mnruecke/RDS_WOTAN/Wotanboard_6CH.png

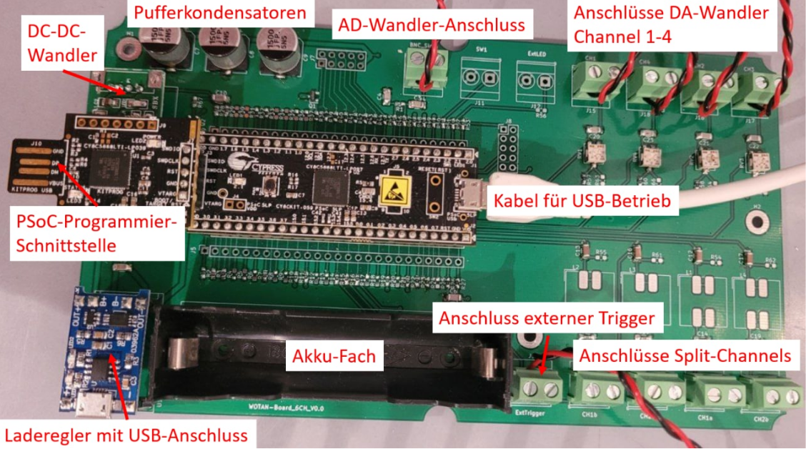
Wotanboard_6CH.png
