mnruecke/RDS_WOTAN/spectrometer_setup.png

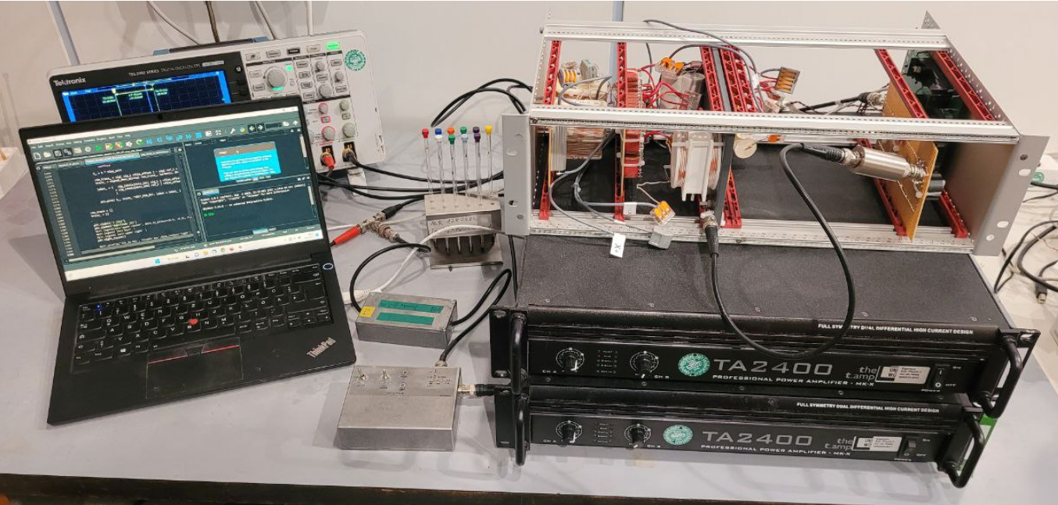
spectrometer_setup.png
