mnruecke/RDS_WOTAN/WOTAN-Board_KiCad/WOTAN-Board_6CH_V0_0.kicad_pcb

## KiCad design WOTAN-Board_KiCad/WOTAN-Board_6CH_V0_0.kicad_pcb (2023-01-04, last stored version)

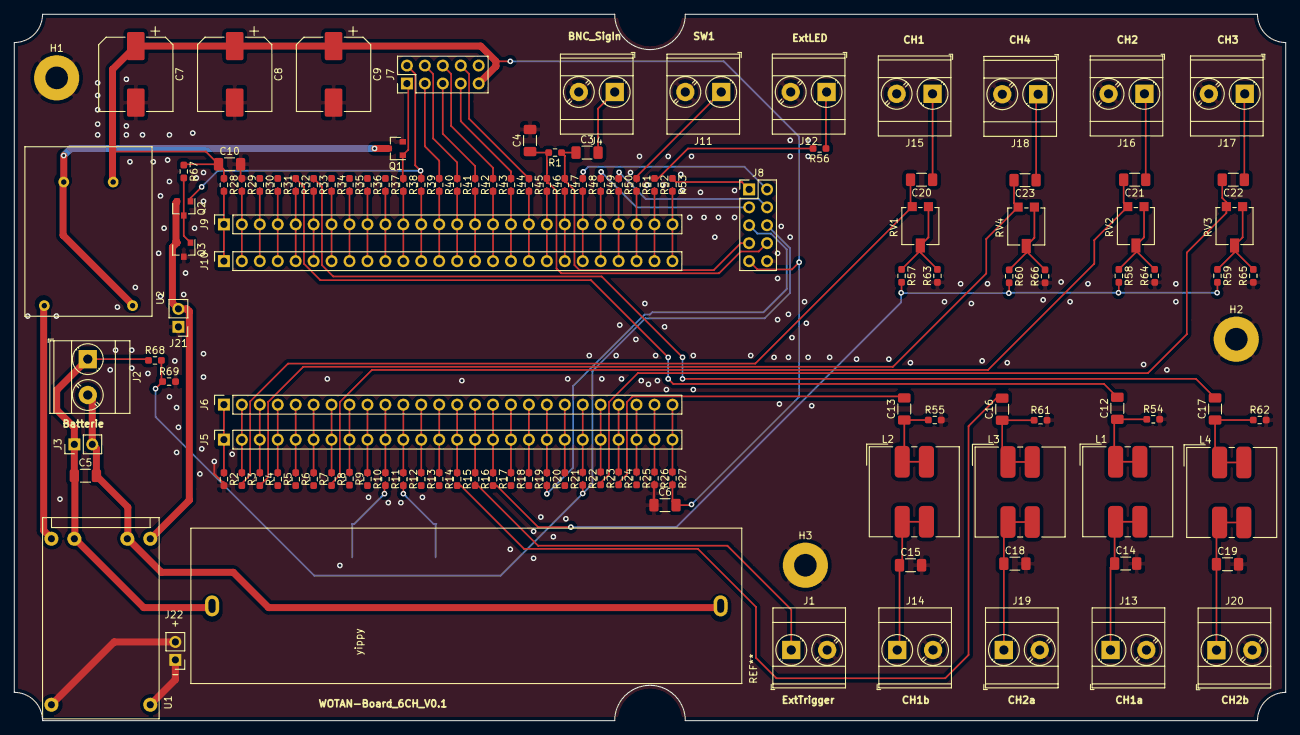
[picture p9: board WOTAN-Board_6CH_V0_0.kicad_pcb from above]

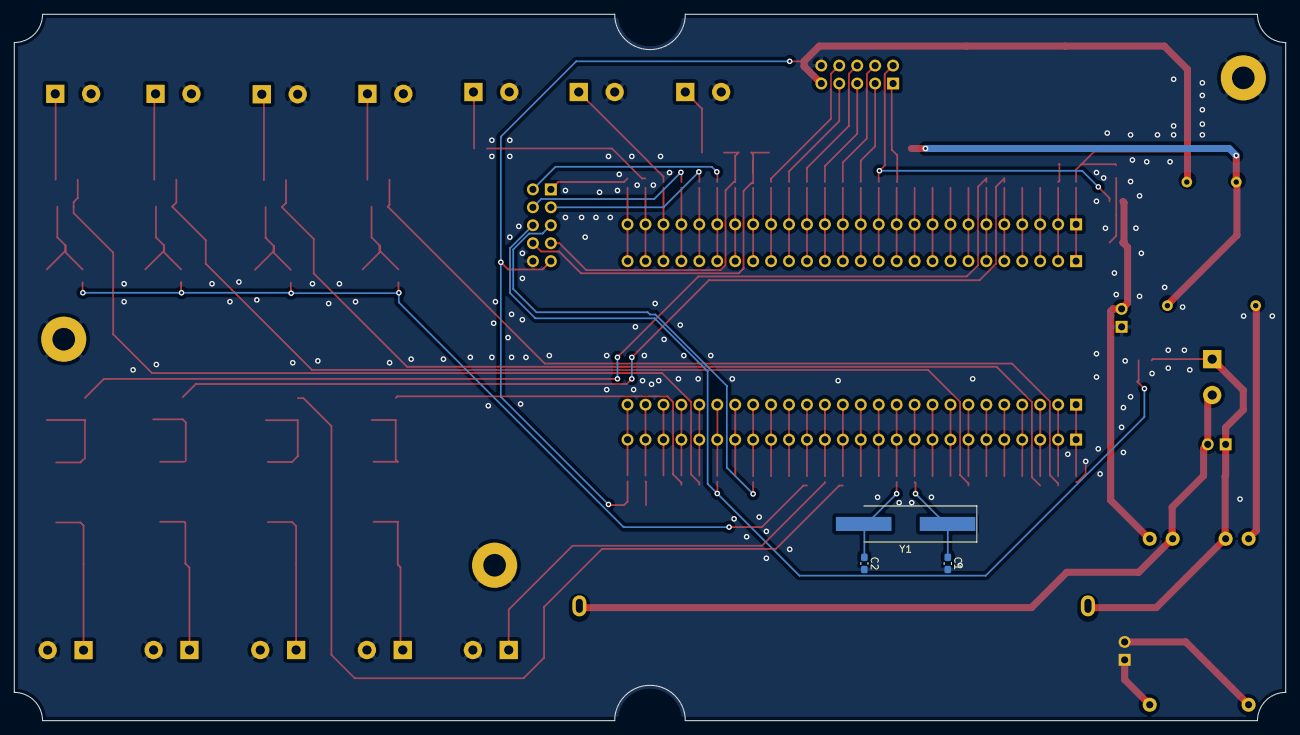
[picture p10: board WOTAN-Board_6CH_V0_0.kicad_pcb from below]

Board: 2 copper layers, 180.0 x 100.0 mm, 130 parts (3 on the bottom side), 108 nets.

Parts:
C1: 33p; C_0603_1608Metric_Pad1.08x0.95mm_HandSolder
C2: 33p (18p eingelötet); C_0603_1608Metric_Pad1.08x0.95mm_HandSolder
C3, C4, C5, C6, C10, C14, C15, C18, C19, C20, C21, C22, C23: 100n; C_1206_3216Metric_Pad1.33x1.80mm_HandSolder
C7, C8, C9: 1500u; CP_Elec_10x10
C12, C13, C16, C17: 100n?; C_1206_3216Metric_Pad1.33x1.80mm_HandSolder
H1, H2, H3: MountingHole_Pad; MountingHole_3.2mm_M3_Pad
J1, J2, J4, J11, J12, J13, J14, J15, J16, J17, J18, J19, J20: Conn_01x02_Female; TerminalBlock_Phoenix_MKDS-3-2-5.08_1x02_P5.08mm_Horizontal
J3, J21, J22: Conn_01x02_Male; PinHeader_1x02_P2.54mm_Vertical
J5, J6, J9, J10: Conn_01x26_Female; PinSocket_1x26_P2.54mm_Vertical
J7, J8: Conn_02x05_Odd_Even; PinHeader_2x05_P2.54mm_Vertical
L1, L2, L3, L4: 1mH; L_Bourns_SRF1260
Q1, Q2, Q3: Q_NMOS_GSD; SOT-23
R1, R68, R69: 1M; R_0603_1608Metric_Pad0.98x0.95mm_HandSolder
R2, R3, R4, R5, R6, R7, R8, R9, R10, R11, R12, R13, R14, R15, R16, R17, R18, R19, R20, R21, R22, R23, R24, R25, R26, R27, R28, R29, R30, R31, R32, R33, R34, R35, R36, R37, R38, R39, R40, R41, R42, R43, R44, R45, R46, R47, R48, R49, R50, R51, R52, R53, R57, R58, R59, R60, R63, R64, R65, R66: 0; R_0603_1608Metric_Pad0.98x0.95mm_HandSolder
R54, R55, R61, R62: 2k; R_0603_1608Metric_Pad0.98x0.95mm_HandSolder
R56: 270; R_0603_1608Metric_Pad0.98x0.95mm_HandSolder
R67: 10M; R_0603_1608Metric_Pad0.98x0.95mm_HandSolder
RV1, RV2, RV3, RV4: 5k; Potentiometer_Vishay_TS53YL_Vertical
U1: LiPo_Charger
U2: UpStep_3Vto5V; UpStep3Vto5V
Y1: 18MHz; Crystal_SMD_HC49-SD_HandSoldering

Connections:
+BATT: C5.1, J2.1, J3.1, R68.1, U1.2
/-BATT: C5.2, J2.2, J3.2, U1.3
/CH1: C20.2, R3.2, RV1.1
/CH1a: C12.2, R32.1
/CH1b: C13.2, R24.2
/CH2: C21.2, R8.2, RV2.1
/CH2a: C16.2, R15.2
/CH2b: C17.2, R33.1
/CH3: C22.2, R23.2, RV3.1
/CH4: C23.2, R4.2, RV4.1
/COM_IDAC: R17.2, R57.2, R58.2, R59.2, R60.2
/ChargeOut+: U1.1, U2.1
/ChargeOut-: J21.2, Q2.2, Q3.2, U1.4
/DCDC_CTRL: J7.1, Q1.1, R38.1
/DCDC_ONOFF: Q1.3, U2.2, U2.3
/ExtTrigger: J1.1, R16.2
/LED1: R52.1, R56.2
/MainSig_inN: C4.1, J8.8, R1.2, R46.1
/MainSig_inP: C3.1, J8.7, R1.1, R47.1
/P12_2: J7.3, R40.1
/P12_3: J7.4, R41.1
/P12_4: J7.5, R42.1
/P12_5: J7.6, R43.1
/P12_6: J7.7, R44.1
/P12_7: J7.8, R45.1
/PWR_EN: J7.2, Q2.1, R39.1
/SW1: J11.1, R51.1
/VDD: C6.2, C7.1, C8.1, C9.1, C10.1, J7.9, J8.9, R27.2, R28.1, R67.1, U2.4
/XTAL1: C1.1, R11.2, Y1.1
/XTAL2: C2.1, R12.2, Y1.2
/aux_sig1: J8.1, R53.1
/aux_sig2: J8.2, R48.1
/aux_sig3: J8.3, R49.1
/aux_sig4: J8.4, R50.1
/aux_sig5: J8.5, R20.2
/aux_sig6: J8.6, R22.2, R68.2, R69.1
GND: C1.2, C2.2, C4.2, C6.1, C7.2, C8.2, C9.2, C10.2, C14.2, C15.2, C18.2, C19.2, H1.1, H2.1, H3.1, J1.2, J4.2, J7.10, J8.10, J11.2, J12.2, J13.2, J14.2, J15.2, J16.2, J17.2, J18.2, J19.2, J20.2, J21.1, Q1.2, Q3.3, R2.2, R26.2, R29.1, R54.2, R55.2, R61.2, R62.2, R63.1, R64.1, R65.1, R66.1, R69.2
unnamed: C3.2, J4.1
unnamed: C12.1, L1.1, L1.2, R54.1
unnamed: C13.1, L2.1, L2.2, R55.1
unnamed: C14.1, J13.1, L1.3, L1.4
unnamed: C15.1, J14.1, L2.3, L2.4
unnamed: C16.1, L3.1, L3.2, R61.1
unnamed: C17.1, L4.1, L4.2, R62.1
unnamed: C18.1, J19.1, L3.3, L3.4
unnamed: C19.1, J20.1, L4.3, L4.4
unnamed: C20.1, J15.1
unnamed: C21.1, J16.1
unnamed: C22.1, J17.1
unnamed: C23.1, J18.1
unnamed: J5.1, J6.1, R2.1
unnamed: J5.2, J6.2, R3.1
unnamed: J5.3, J6.3, R4.1
unnamed: J5.4, J6.4, R5.1
unnamed: J5.5, J6.5, R6.1
unnamed: J5.6, J6.6, R7.1
unnamed: J5.7, J6.7, R8.1
unnamed: J5.8, J6.8, R9.1
unnamed: J5.9, J6.9, R10.1
unnamed: J5.10, J6.10, R11.1
unnamed: J5.11, J6.11, R12.1
unnamed: J5.12, J6.12, R13.1
unnamed: J5.13, J6.13, R14.1
unnamed: J5.14, J6.14, R15.1
unnamed: J5.15, J6.15, R16.1
unnamed: J5.16, J6.16, R17.1
unnamed: J5.17, J6.17, R18.1
unnamed: J5.18, J6.18, R19.1
unnamed: J5.19, J6.19, R20.1
unnamed: J5.20, J6.20, R21.1
unnamed: J5.21, J6.21, R22.1
unnamed: J5.22, J6.22, R23.1
unnamed: J5.23, J6.23, R24.1
unnamed: J5.24, J6.24, R25.1
unnamed: J5.25, J6.25, R26.1
unnamed: J5.26, J6.26, R27.1
unnamed: J9.1, J10.1, R28.2
unnamed: J9.2, J10.2, R29.2
unnamed: J9.3, J10.3, R30.2
unnamed: J9.4, J10.4, R31.2
unnamed: J9.5, J10.5, R32.2
unnamed: J9.6, J10.6, R33.2
unnamed: J9.7, J10.7, R34.2
unnamed: J9.8, J10.8, R35.2
unnamed: J9.9, J10.9, R36.2
unnamed: J9.10, J10.10, R37.2
unnamed: J9.11, J10.11, R38.2
unnamed: J9.12, J10.12, R39.2
unnamed: J9.13, J10.13, R40.2
unnamed: J9.14, J10.14, R41.2
unnamed: J9.15, J10.15, R42.2
unnamed: J9.16, J10.16, R43.2
unnamed: J9.17, J10.17, R44.2
unnamed: J9.18, J10.18, R45.2
unnamed: J9.19, J10.19, R46.2
unnamed: J9.20, J10.20, R47.2
unnamed: J9.21, J10.21, R48.2
unnamed: J9.22, J10.22, R49.2
unnamed: J9.23, J10.23, R50.2
unnamed: J9.24, J10.24, R51.2
unnamed: J9.25, J10.25, R52.2
unnamed: J9.26, J10.26, R53.2
unnamed: J12.1, R56.1
unnamed: Q2.3, Q3.1, R67.2
unnamed: R57.1, R63.2, RV1.2, RV1.3
unnamed: R58.1, R64.2, RV2.2, RV2.3
unnamed: R59.1, R65.2, RV3.2, RV3.3
unnamed: R60.1, R66.2, RV4.2, RV4.3
