mnruecke/RDS_WOTAN/(commit log)

2023-01-04 raw files of spectrometer console and pcb files
    [Stückliste.xlsx, Stückliste_Boehn_EWerkstatt.xlsx, WOTAN-Board_6CH_V0_0.kicad_pcb, WOTAN-Board_6CH_V0_0.sch]
2023-02-03 rawfiles for RDS spectrometer
    [Stückliste.xlsx, Stückliste_Boehn_EWerkstatt.xlsx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]
2023-02-03 make repo clean
    [Stückliste.xlsx, Stückliste_Boehn_EWerkstatt.xlsx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]
2023-02-24 introduce board coupling code (stubs only)
2023-02-24 Expand test code for direct board coupling
2023-02-25 fixing sync test routine (initiation command still not implemented)
    [main.c]
2023-02-27 master-slave uart communication running, but command gets transmitted errornes
    [main.c]
2023-03-01 Master Slave combination working if two usbfs connections are used for adc data
2023-03-01 Master Slave with two usbfs working - but with drastic noise increase
    [main.c]
2023-04-06 running - but needs reset after sequence_write for rx to work
    [main.c, rds_essentials.py, rds_run_sequence.py, rds_write_sequence.py]
2023-04-09 added adcs to rds v2 - data corupted if n_adc_samples > 12800 - psoc freezes after sending adc data
2023-04-10 fixing adc sampling -> 30 000 samples / 15 ms, send adc data in 60 byte packages each requested individually
    [adcs.c, dacs.h, psoc_core.c, psoc_core.h, rds_v2_test.py]
2023-04-12 fix clock tree behaviour diff between reset and power cycling, minor clean ups
    [psoc_core.c, rds_v2_test.py]
2023-04-14 complete wavelet generation, trigger out indicates adc sampling window (+ safety margin)
